Jojo-Penrose/ME-405-Romi/docs/img/dist.jpg

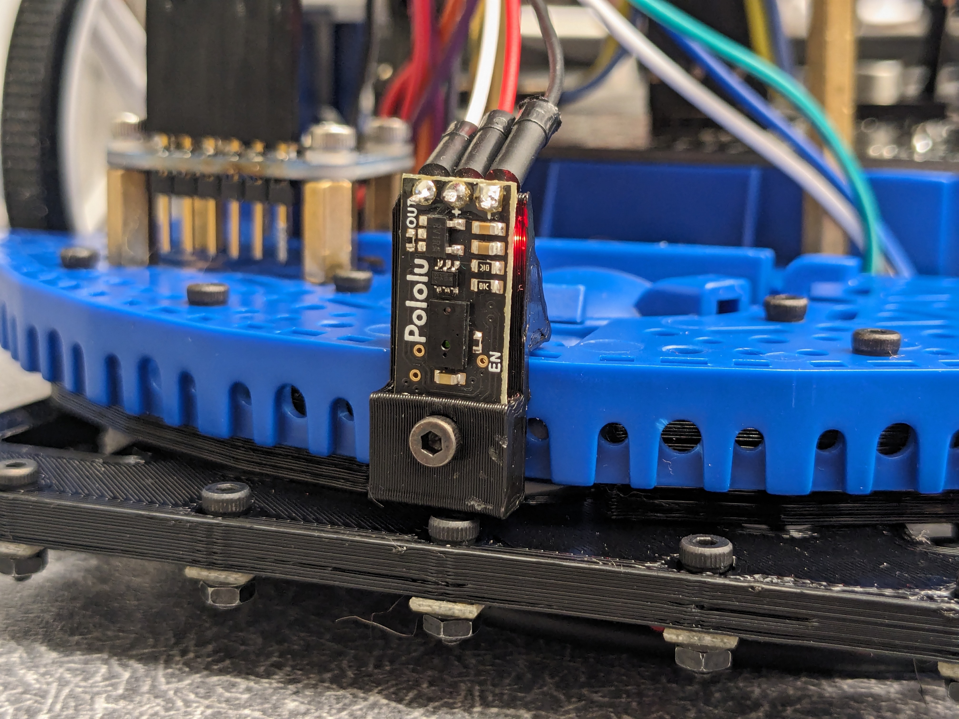
docs/img/dist.jpg
