Jojo-Penrose/ME-405-Romi/docs/img/romi.jpg

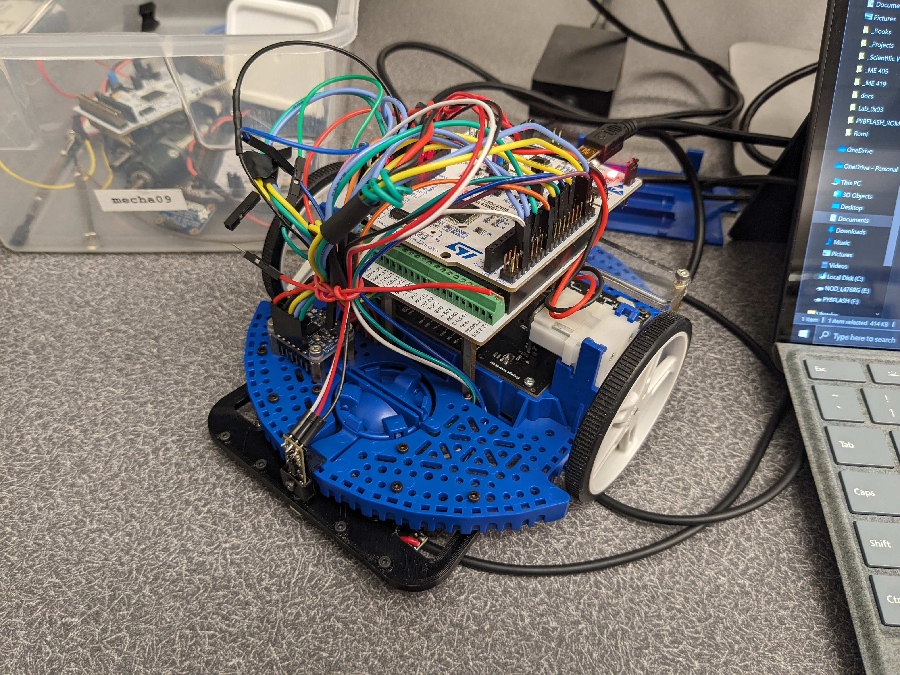
docs/img/romi.jpg
