Jojo-Penrose/ME-405-Romi/docs/img/arcdist.jpg

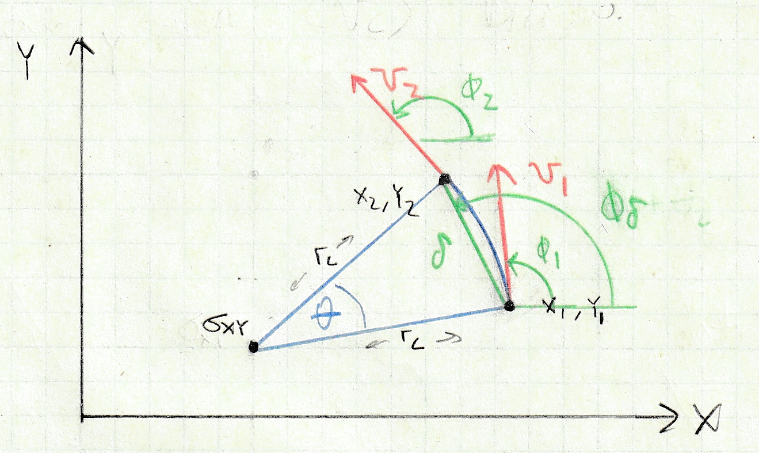
docs/img/arcdist.jpg
