Jojo-Penrose/ME-405-Romi/docs/img/arcpos.jpg

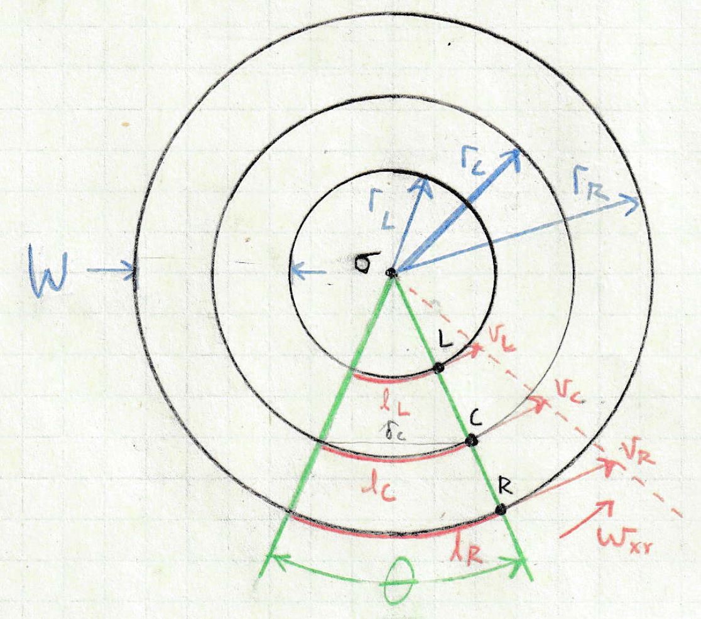
docs/img/arcpos.jpg
