Jojo-Penrose/ME-405-Romi/docs/img/arcvel.jpg

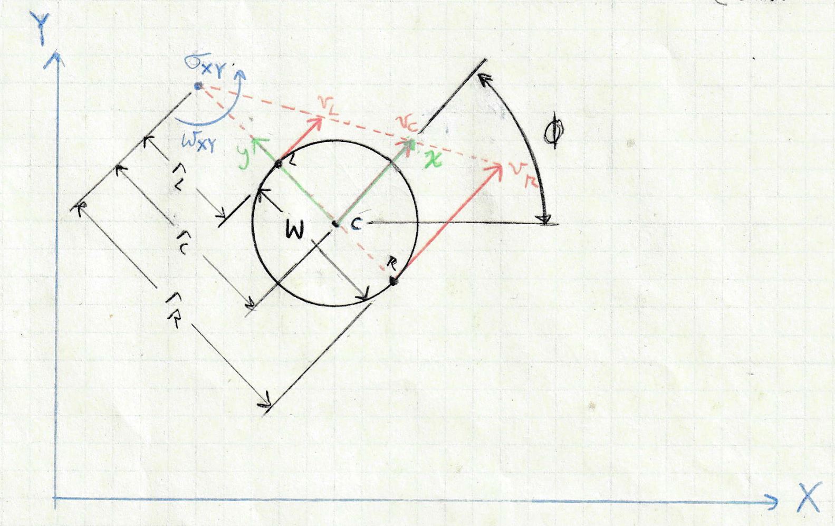
docs/img/arcvel.jpg
