Jojo-Penrose/ME-405-Romi/docs/img/righttrialt.jpg

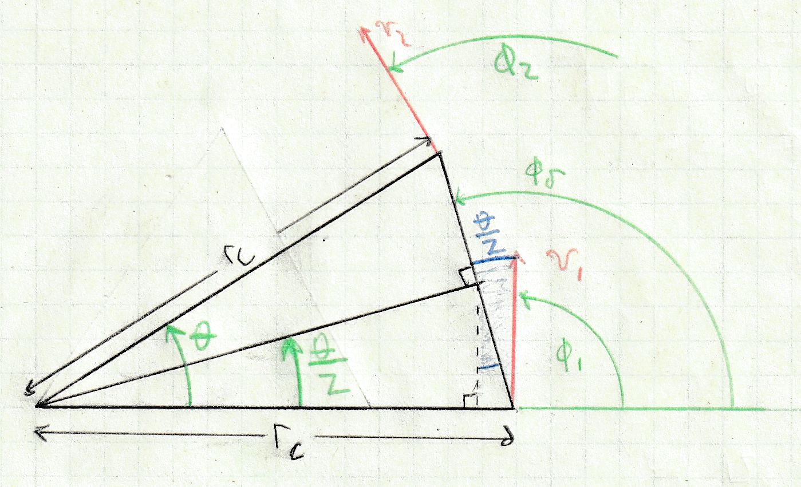
docs/img/righttrialt.jpg
