Jojo-Penrose/ME-405-Romi/docs/img/sensor.jpg

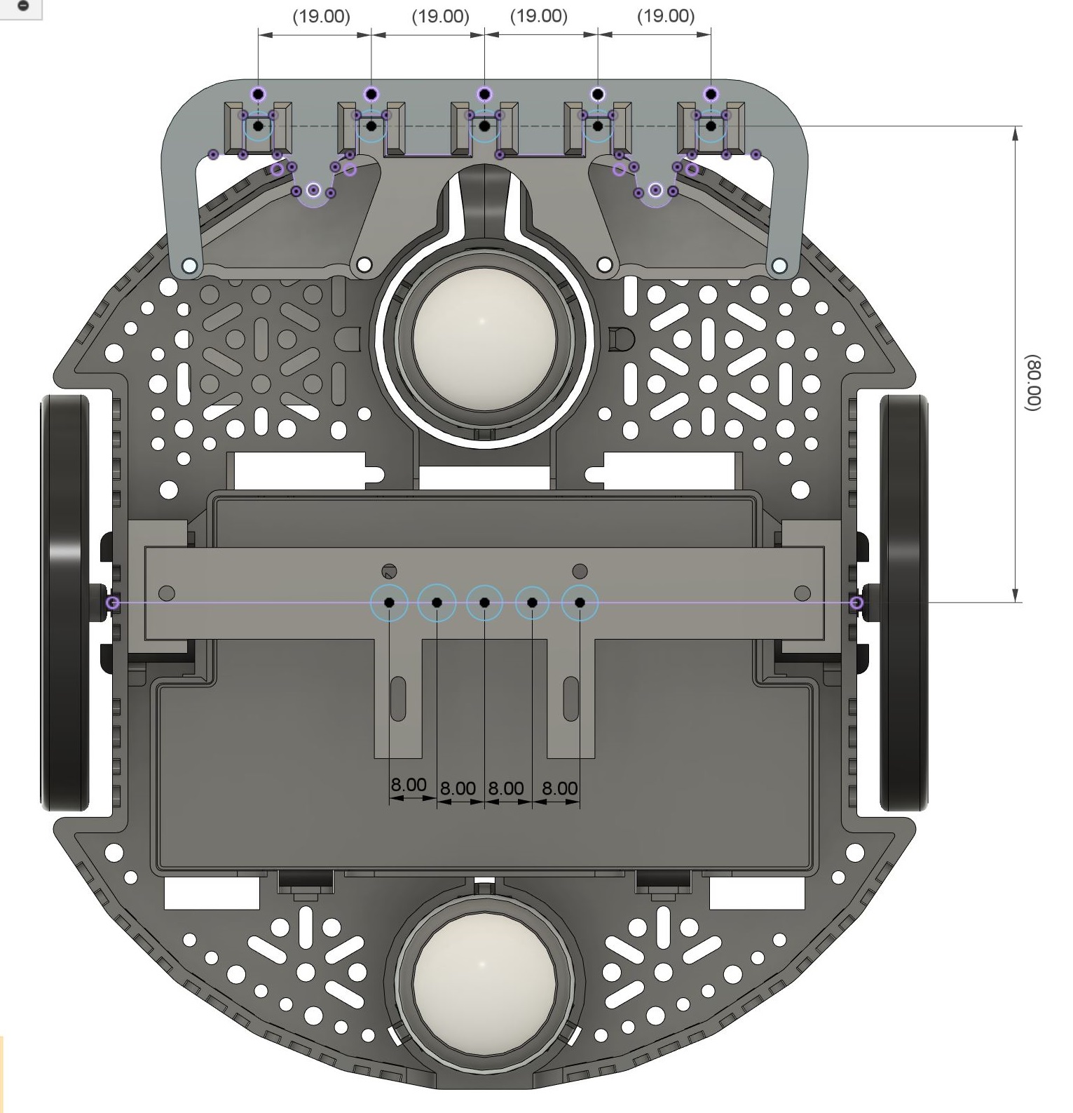
docs/img/sensor.jpg
