Jojo-Penrose/ME-405-Romi/docs/img/sensor_locations.JPG

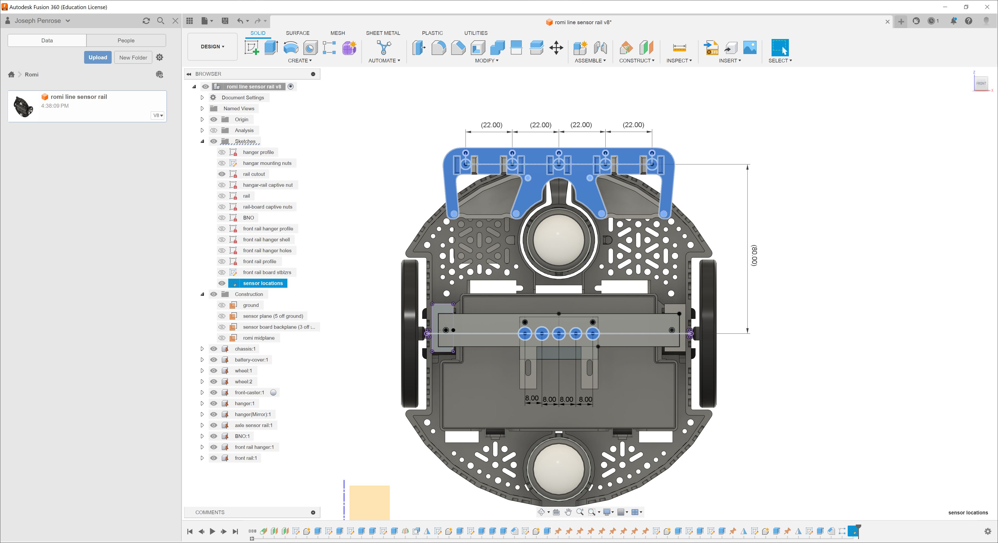
docs/img/sensor_locations.JPG
