Jojo-Penrose/ME-405-Romi/docs/img/tighter sensors.JPG

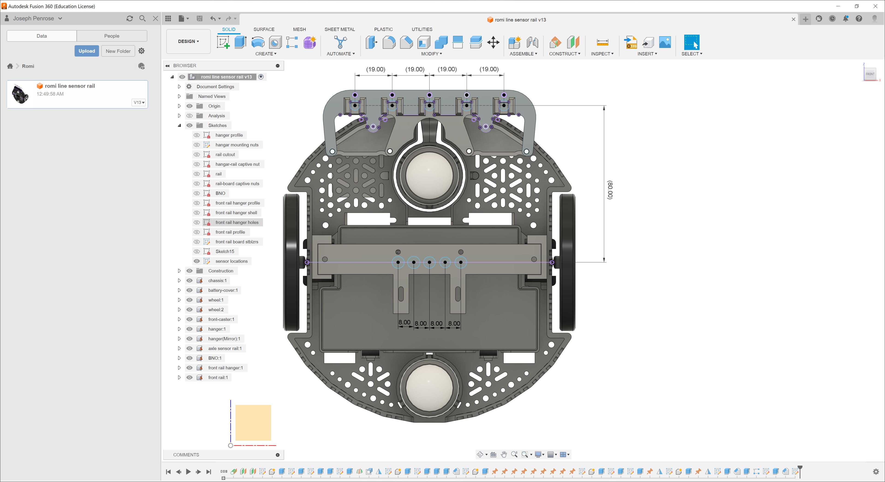
docs/img/tighter sensors.JPG
