Jojo-Penrose/ME-405-Romi/docs/img/track.jpg

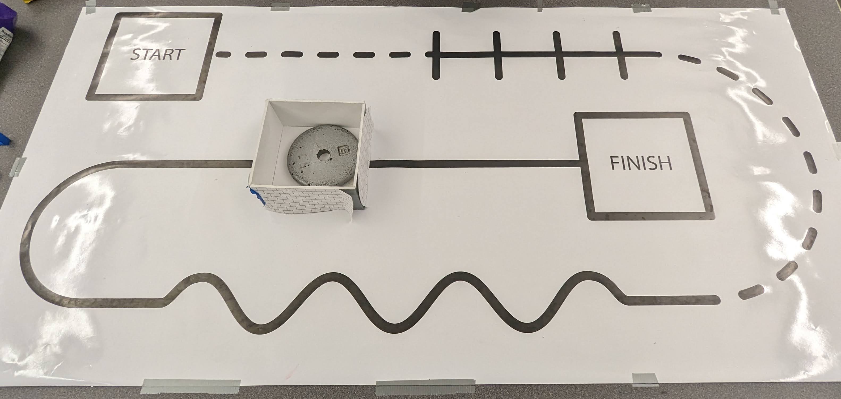
docs/img/track.jpg
