Jojo-Penrose/ME-405-Romi/models/Axial_Right_Rail_Mount.stl

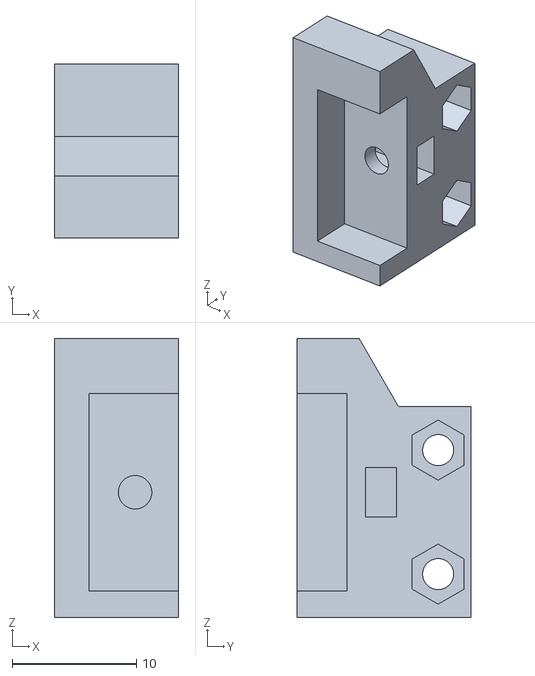
[picture p11: CAD file, 2023-12-15]
models/Axial_Right_Rail_Mount.stl
10.0 x 14.0 x 22.5
