Jojo-Penrose/ME-405-Romi/models/Front_Left_Rail_Mount.stl

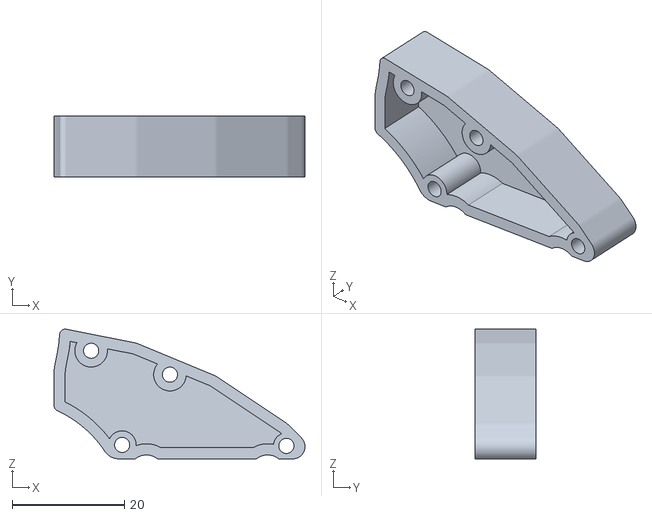
[picture p12: CAD file, 2023-12-15]
models/Front_Left_Rail_Mount.stl
44.8 x 10.9 x 23.2
