Jojo-Penrose/ME-405-Romi/models/Axial_Line_Sensor_Rail.stl

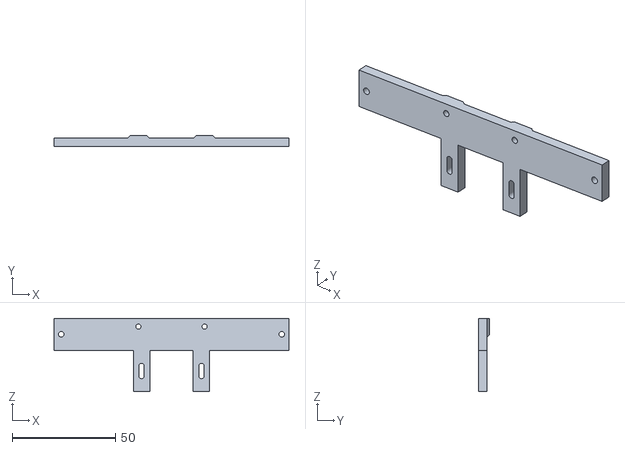
[picture p13: CAD file, 2023-12-15]
models/Axial_Line_Sensor_Rail.stl
113.7 x 5.13 x 35.5
