Jojo-Penrose/ME-405-Romi/models/Front_Line_Sensor_Rail.stl

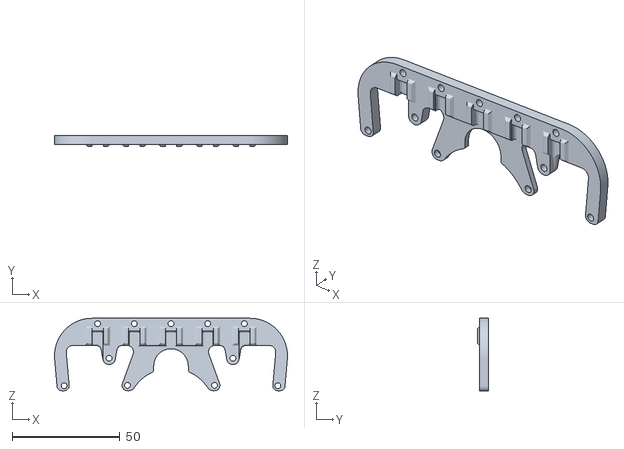
[picture p14: CAD file, 2023-12-15]
models/Front_Line_Sensor_Rail.stl
108.0 x 5.13 x 33.6
