Jojo-Penrose/ME-405-Romi/(list of files, cad)

Other CAD files:
models/Front_Right_Rail_Mount.stl
models/Axial_Left_Rail_Mount.stl
