Jojo-Penrose/ME-405-Romi/PYBFLASH/boot.py

'''!@file boot.py
    @brief      MicroPython boot file for STM32
    @details    run on boot to configure USB and filesystem
                Put app code in main.py
'''
import machine
import pyb
pyb.country('US') # ISO 3166-1 Alpha-2 code, eg US, GB, DE, AU
#pyb.main('main.py') # main script to run after this one
#pyb.usb_mode('VCP+MSC') # act as a serial and a storage device
#pyb.usb_mode('VCP+HID') # act as a serial device and a mouse
