Jojo-Penrose/ME-405-Romi/(commit log)

2023-12-13 First commit of PYBFLASH.
    Project is almost complete. The only function missing is the "return to start" routine at the finish line.
    [BNO.py, LidarSensor.py, LineCL.py, LineSensors.py, RomiEnc.py, RomiMM.py, RomiMot.py, boot.py]
2023-12-14 List of Romi pins and wires.
2023-12-15 Commit 3D hardware models
    [Axial_Left_Rail_Mount.stl, Axial_Line_Sensor_Rail.stl, Axial_Right_Rail_Mount.stl, Front_Left_Rail_Mount.stl, Front_Line_Sensor_Rail.stl, Front_Right_Rail_Mount.stl]
